MigNygro/tcc-conversor-flyback/02_Calculos/Especificações_TCC.xlsx

Sheet: Dados_Projeto
Dados Basicos do Projeto |  |  | Dados do Indutor Acoplado |  |  | LEGENDA
Parametro | Valor | Unidade | Modelo | T106-26 |  |  | Dado Manual do Usuário
V microcontrolador | 5 | V | Lm | 450000 | uH |  | Dado Calculado
V in(max) | 12 | V | Fio | 24 | AWG
V in rms | 12 | V | Voltas N1 p/ Fio | 69 | Voltas
V in(min) | 12 | V | Qntd Fios N1 | 1 | Fios
V out | 5 | V | Qntd Fios N2 | 12.32 | Fios
R out | 10 | Ω | Total Voltas | 1 | Voltas
L Trafo Requerido | 450 | uH | N2/N1 | 0.1785714286 | Constante
L Trafo Requerido | 0.00045 | H | Capacitor Comercial | 3.3e-05 | Faraday
N1/N2 | 4.5 | - | Capacitor Comercial | 33 | uF
N1/N2 | 5.6 | -
Escolha o Mosfet | IRF640
Frequência | 62.5 | kH | Valor Medido | 1.495 | mH
Frequência | 62500 | H | Voltas | 20
β(SAT) | 10 |  | Nano Henry | 1495000
I min gate Drive (IC) | 1 | mA | Al Medido | 3737.5 | nH/N^2
I min gate Drive (IC) | 0.001 | A
I máx Gate Mosfet 1% | 0.254 | A | Valor Medido | 0.013 | mH
I máx Gate Mosfet 1% | 254 | mA | Voltas | 10
Rb Opto | 18000 | Ω | Nano Henry | 13000
R1 Gate Drive | 4700 | Ω | Al Medido | 130 | nH/N^2
R2 Gate Drive | 470 | Ω
R3 Gate Drive / Rg Mosfet | 47 | Ω
Definições para o Flyback
∆ Vo | 1 | %
V diodo | 0.7 | V
Duty Cicle | 0.7 | num
B max | 0.25 | Tesla
Tipo da Condução | Contínuo
Tipo do Indutor | Toroidal
Tipo da Condução | Qual Fio
Fio AWG | 24 | AWG

Sheet: Estudo_Drive
 | 1.39 |  |  |  |  | aaaaaaaaaaaaaaaaaaaa | aaaaaa | aaaaa | Vcc Arduino | 5 |  | mA
 | 1.666666667 |  |  |  |  |  |  |  | Vcc | 12 | V
IB3 | 1666.666667 | mA | Ib Entrada | 2 | mA |  |  |  | Ig | 0.254 | A | 254
IB3 | 0.001 | A | Ib Entrada | 0.002 | A |  |  |  | R3 | 47.24409449 | Ω
β(SAT) | 10 | num | V microcontrolador | 5 | V |  |  |  | R3 cmc | 47 | Ω
IC3 | 16666.66667 | mA | R1 Rb | 2500 | Ohm
IC3 | 16.66666667 | A | Resistor cmc | #REF! | Ohm |  |  |  | Ec | 7.2e-08 | J
Vdd | 12 | V |  |  |  |  |  |  | Ec | 72 | nJ
R3 | 0.72 | Ω |  |  |  |  |  |  | T esquisito | 4.724409449e-08 | s
R3 cmc | #REF! | Ω |  |  |  |  |  |  | T esquisito | 47.24409449 | ns
Ciss | 1 | nF | R1 do Drive usando BC337 e ib = 2 mA |  |  | R2 do Drive usando BC337 e ib = 2 mA |  |  | t | 236.2204724 | ns
E | 7.2e-08 | J | Relação Ib/Ic | 10 |  | Relação Ib/Ic | 10
E | 72 | J | Ib Q1 | 2 | mA | Ib Q1 | 20 | mA | f | 62500 | hz
t | 7.2e-10 | s | Ic Q1 | 20 | mA | Ic Q1 | 200 | mA | T | 1.6e-05 | s
t | 0.72 | ns | Ic Q1 | 0.02 | A | Ic Q1 | 0.2 | A | T | 16 | us
t | 3.6e-09 | s | Vdd = vcc | 12 | V | Vdd = vcc | 12 | V
t | 3.6 | ns | Rc Q1/ Rb Q2 | 600 | Ohm | Rc Q1/ Rb Q2 | 60 | Ohm | P | 4.5 | mW
 |  |  | Rc Q1/ Rb Q2 cmc | #REF! | Ohm | Rc Q1/ Rb Q2 cmc | #REF! | Ohm
T | 1.6e-05 | s | Ic Q1 = Ib Q2 | #REF! | A | Ic Q1 = Ib Q2 | #REF! | A | IB3 = IR2 | 0.0254 | A | 25.4
T | 16000 | ns | Ic Q1 = Ib Q2 | #REF! | mA | Ic Q1 = Ib Q2 | #REF! | mA | R2 | 444.8818898 | Ω | Menor Melhor
Pmed | 0.0045 | W |  |  |  |  |  |  | R2 cmc | 470 | Ω
Pmed | 4.5 | mW
 |  |  | R1 do Drive usando Opto |  |  | R2 do Drive usando Opto |  |  | Ib2 = Ic2/10 | 0.00254 | A | 2.54
IB3 | 1666.666667 | mA | Relação Ib/Ic | 10 |  | Relação Ib/Ic | 10 |  | R1 | 4448.818898 | Ω
IB3 | 1.666666667 | A | Ib Q1 | 5 | mA | Ib Q1 | 0.5 | mA | R1 cmc | 4700 | Ω
R2 | 6.78 | Ω | Ic Q1 | 0.5 | mA | Ic Q1 | 5 | mA
R2 cmc | #REF! | Ω | Ic Q1 | 0.0005 | A | Ic Q1 | 0.005 | A | Ib2 = Ic2/10 | 0.000254 | A | 0.254
 |  |  | Vdd = vcc | 12 | V | Vdd = vcc | 12 | V | R1 | 16929.13386 | Ω
IC2 | 1666.666667 | mA | Rc Q1/ Rb Q2 | 24000 | Ohm | Rc Q1/ Rb Q2 | 2400 | Ohm | R1 cmc | 18000 | Ω
IC2 | 1.666666667 | A | Rc Q1/ Rb Q2 cmc | #REF! | Ohm | Rc Q1/ Rb Q2 cmc | #REF! | Ohm
IB2 | 166.6666667 | mA | Ic Q1 = Ib Q2 | #REF! | A | Ic Q1 = Ib Q2 | #REF! | A
IB2 | 0.1666666667 | A | Ic Q1 = Ib Q2 | #REF! | mA | Ic Q1 = Ib Q2 | #REF! | mA
R1 | 67.8 | Ω
R1 cmc | #REF! | Ω

Sheet: Estudo_Mosfet
MOSFET P75NF75 |  |  |  |  |  |  | MOSFET IRF540
Circ. Teste Datasheet | Parâmetro | Descrição | Condição | Valor Típico | Valor Máximo | Unidade | Circ. Teste Datasheet | Parâmetro | Descrição | Condição | Valor Típico | Valor Máximo | Unidade
 | tD(ON) | Turn-On Delay Time | VDD=37,5V, ID=45A, VGS=10V, RG=4,7Ω | 25 |  | ns |  | tD(ON) | Turn-On Delay Time | VDD=37,5V, ID=45A, VGS=10V, RG=4,7Ω | 8 |  | ns
 | tR | Turn-On Rise Time | VDD=37,5V, ID=45A, VGS=10V, RG=4,7Ω | 100 |  | ns |  | tR | Turn-On Rise Time | VDD=37,5V, ID=45A, VGS=10V, RG=4,7Ω | 39 |  | ns
 | tD(OFF) | Turn-Off Delay Time | VGS=10V, RG=4,7Ω | 66 |  | ns |  | tD(OFF) | Turn-Off Delay Time | VGS=10V, RG=4,7Ω | 26 |  | ns
 | tF | Turn-Off Fall Time | VGS=10V, RG=4,7Ω | 30 |  | ns |  | tF | Turn-Off Fall Time | VGS=10V, RG=4,7Ω | 24 |  | ns
 | Qg | Total Gate Charge | VDS=60V, VGS=10V, ID=80A | 117 | 160 | nC |  | Qg | Total Gate Charge | VDS=60V, VGS=10V, ID=80A | 65 |  | nC
 | Qgs | Gate-Source Charge | VDS=60V, VGS=10V, ID=80A | 27 |  | nC |  | Qgs | Gate-Source Charge | VDS=60V, VGS=10V, ID=80A | 10 |  | nC
 | Qgd | Gate-Drain Charge | VDS=60V, VGS=10V, ID=80A | 47 |  | nC |  | Qgd | Gate-Drain Charge | VDS=60V, VGS=10V, ID=80A | 29 |  | nC
 | Ciss | Imput Capacitance | VGS = 0 V, VDS = 25 V f = 1MHz | 3700 |  | pF |  | Ciss | Imput Capacitance | VGS = 0 V, VDS = 25 V f = 1MHz | 890 | 1187 | pF
Dados Calculados | Qg Medio | Total Gate Charge | VDS=60V, VGS=10V, ID=80A | 139 |  | nC | Dados Calculados | Qg Medio | Total Gate Charge | VDS=60V, VGS=10V, ID=80A | 65 |  | nC
 | Ig Max | Corrente no Gate Max | VDS=60V, VGS=10V, ID=80A | 1.39 |  | A |  | Ig Max | Corrente no Gate Max | VDS=60V, VGS=10V, ID=80A | 1.666666667 |  | A
 | p% Pulso | Porcentagem de Pulso |  | 0.8 |  | % |  | p% Pulso | Porcentagem de Pulso |  | 1.6 |  | %
 | F tr | Frequencia de Trabalho |  | 62.5 |  | kH |  | F tr | Frequencia de Trabalho |  | 62.5 |  | kH
 | F tr | Frequencia de Trabalho |  | 62500 |  | H |  | F tr | Frequencia de Trabalho |  | 62500 |  | H
 | T tr | Periodo de Trabalho |  | 1.6e-05 | 10 | s |  | T tr | Periodo de Trabalho |  | 1.6e-05 |  | s
 | T tr | Periodo de Trabalho |  | 16000 |  | ns |  | T tr | Periodo de Trabalho |  | 16000 |  | ns
 | T pulso | T Pulso para não Aquecer o Mosfet + que 1% do Tr |  | 1.28e-07 |  | s |  | T pulso | T Pulso para não Aquecer o Mosfet + que 1% do Tr |  | 2.56e-07 |  | s
 | T pulso | T Pulso para não Aquecer o Mosfet + que 1% do Tr |  | 128 |  | ns |  | T pulso | T Pulso para não Aquecer o Mosfet + que 1% do Tr |  | 256 |  | ns
 | Ig Pulso | Corrente de Gate para esse pulso de 1% de Tr |  | 1.086 | 1.39 | A |  | Ig Pulso | Corrente de Gate para esse pulso de 1% de Tr |  | 0.254 | 1.666666667 | A
 | Vcc drive | Tensão de entrada ou do drive que irá adionar o mosfet |  | 12 |  | V |  | Vcc drive | Tensão de entrada ou do drive que irá adionar o mosfet |  | 12 |  | V
 | Rg | R gate do Mosfet para acionar em 1,086 A |  | 11.05 |  | Ohm |  | Rg | R gate do Mosfet para acionar em 0,254 A |  | 47.24 |  | Ohm
 | Rg cmc | R gate do Mosfet Comercial |  | 47 |  | Ohm |  | Rg cmc | R gate do Mosfet Comercial |  | 47 |  | Ohm
 |  | perda de potencia no mosfet
Link youtube | MOSFET: Acionamento do gate, resistência do gate (https://www.youtube.com/watch?v=UnN3hBL277I) | MOSFET: Por que usar a resistência de gate? (https://www.youtube.com/watch?v=WTB71her32k)

Sheet: Calculo_FlyBack_Simples
 |  |  | AAAAAA |  | aaaaaaa | aaaaaa | aaaaaaaaa |  | aaaaaaa | AAAAAA
 |  |  |  | Dados Basicos do Projeto |  |  | Teste do Modo de Operação |  |  |  | Cálculo do Fio Mínimo Bobina
Tap Trafo | Trafo Antigo |  |  | Parametro | Valor | Unidade | Parametro | Valor | Unidade |  | Parametro | Valor | Unidade
1º | 0.446 | mH |  | V in(max) | 12 | V | N1/N2 | 4.5000 |  |  | Profundidade de Penetração | 0.02648 | cm
 | 446 | uH |  | V in rms | 12 | V | N1/N2 | 5.6000 | 0.1785714286 |  | Diametro do Fio | 0.05296 | cm
2º | 0.099 | mH |  | V in(min) | 12 | V | N2/N1 | 0.2222 |  |  | Área do Fio (Aw) | 0.0022 | cm²
 | 99 | uH |  | V out (1) | 5 | V | N2/N1 | 0.1786 | 5.6 |  | Fio Mínimo Escolhido
N1/N2 | 4.505050505 |  |  | R out (1) | 100 | Ω | D (Max Real) | 0.7000 |  |  | Área do Fio (AWG) Mínimo | 0.00205 | cm²
N2/N1 | 0.2219730942 |  |  | I out (1) | 0.05 | A | N1/N2 | 4.5000 | - |  | Fio AWG | 24 | AWG
 |  |  |  | P out (1) | 0.25 | W | I Lm | 0.030 | A |  | Resistência | 842.1 | uΩ/cm 22º C
 |  |  |  | Duty Cicle | 0.7 |  | Qual Duty Cicle | Original |  |  | Fio AWG Escolhido | 24 | AWG
 |  |  |  | L Trafo Requerido | 450 | uH | ∆ I Lm | 0.299 | A |  | Área do Fio (AWG) Mínimo | 0.00205 | cm²
 |  |  |  | L Trafo Requerido | 0.00045 | H | Lm | 0.00045 | H |  | Resistência | 842.1 | uΩ/cm 22º C
 |  |  |  | ∆ Vo | 2 | % | Lm | 450 | uH
 |  |  |  | Frequência | 62.5 | kH | I Lm mín | -0.1193333333 | A |  | Imax | 0.1793333333 | A
 |  |  |  | Frequência | 62500 | H |  |  |  |  | Imax 1% | 0.001793333333 | A
 |  |  |  | Tipo da Condução | Contínuo |  | I Lm máx | 0.1793333333 | A |  | Imax 1% | 1.79 | mA
 |  |  |  | Tipo do Transformador | Toroidal |  | Modo de Operação Segundo Hart |  |  |  | R snubber | 6691 | Ω |  | 3.2e-09
 |  |  |  | Calculos Periodo |  |  | Descontínuo |  |  |  | R snubber cmc | 6800 | Ω |  | 3.2 | nJ
 |  |  |  | Periodo T | 1.6e-05 | s | Definindo o Núcleo |  |  |  | R snubber cmc | 6.8 | kΩ
 |  |  |  | Ton | 1.12e-05 | s | Al do Núcleo | 93 | nH/Np² |  | Ei | 7.2361e-10 | J |  | 6.4
 |  |  |  |  | 100 |  | Lm | 450000 | nH |  | Ei | 0.72361 | nJ
 |  |  |  |  |  |  | Número de Voltas Primário | 69 | Voltas |  | V teste | 2 | V
 |  |  |  |  |  |  | Qntd Fios Primario | 1 | Fios |  | c snb | 3.61805e-10 | J
 |  |  |  |  |  |  | Número de Voltas Secundário | 15.33333333 | Voltas |  | c snb | 0.000361805 | uF
 |  |  |  |  |  |  | Qntd Fios Secundário | 1 | Fios |  | c snb cmc | 4.7e-10 | F
 |  |  |  |  |  |  | Qual Fio | 24 | AWG |  | c snb cmc | 470 | pF | 0.47
 |  |  |  |  |  |  | Número de Voltas Secundário | 12.32 | Voltas |  | C carga | 2.8e-05 | 0.012
 |  |  |  |  |  |  | Qntd Fios Secundário | 1 | Fios |  | C Carga cmc | 3.3e-05 | F
 |  |  |  |  |  |  | Qual Fio | 0 | AWG |  | C Carga cmc | 33 | uF |  | 3300 | 3300
 |  |  |  |  |  |  | Modo de Operação Segundo Hart
 |  |  |  |  |  |  | Contínuo
 |  |  |  |  |  |  | 0.00225792 | lm
 |  |  |  |  |  |  | 2257.92 | uLm
 |  |  |  |  |  |  | 11.2

Sheet: Planilha1
Item | Valor aproximado (R$)
Microcontrolador | XX,00
MOSFET de potência | XX,00
Núcleo toroidal | XX,00
Componentes passivos | XX,00
Custo total estimado | XX,00

Sheet: Estudo_OptoAcoplador
OPTOACOPLADOR 4N25
Circuito | Parametro | Valor | Unidade |  | Parametro | Valor | Unidade
Circ. Teste Datasheet Vin | IC | 1 | mA |  | Ton | 2 | us
 | IC | 0.001 | A |  |  | 2e-06 | s
 | Vcc | 10 | V |  | Toff | 2 | us
 | RL | 100 | Ohm |  |  | 2e-06 | s
 | CTR | 20 | % |  | T Total | 4 | us
 | IF | 5 | mA
 | I coletor | 0.0002 | A |  |  | 4e-06 | s
 | I coletor | 0.2 | mA |  | F máx 0,10 mA | 0.25 | MH
 | Queda T Vrl | 0.02 | V |  |  | 250 | kH
 | Vce Final | 9.98 | V |  |  | 250000 | H
 | V F Led Emissor Tip | 1.18 | V
 | V F Led Emissor Max | 1.5 | V
Circ. Micro Controlador | Vcc/Vin MicroContr | 5 | V
 | V F Led | 1.18 | V
 | I base Led | 5 | mA
 | I base Led | 0.005 | A
 | ResistenciaRg | 764 | Ohm
 | Resistencia Comerc. | 18000 | Ohm | Menor
 | I Base Led New | 0.0002122222222 | A
 | I Base Led New | 0.2122222222 | mA
 | Diferença I base | -95.76 | %

Sheet: Anal_Tubes
Numero | Diâmetro | Espiras | Área | Resistência | Peso | Comprim. | Corrente máxima (A) |  |  | Frequência | Corrente_Max | Frequencia | 5 % HZ | Teste_HZ | Qntd_Fios | Corrente_2 | Qntd_Fios_2
AWG | (mm) | por cm | (mm2) | (Ω/km) | (kg/km) | (m/kg) | 2,5A/mm2 | 3A/mm2 | 6A/mm2 | máx. (kHz) | A | Hz | Hz | - | Numero |  | Numero
1 | 7.3482 | 1.361 | 42.409 | 0.406 | 380 | 2.6317 | 106.022 | 127.226 | 254.453 | 0.323 | 0.1793333333 | 62.5 | 59.375 | Não |  | 0.05
2 | 6.5438 | 1.528 | 33.632 | 0.511 | 301.3 | 3.3185 | 84.08 | 100.896 | 201.792 | 0.407 | 0.1793333333 | 62.5 | 59.375 | Não |  | 0.05
3 | 5.8275 | 1.716 | 26.671 | 0.645 | 239 | 4.1845 | 66.679 | 80.014 | 160.029 | 0.513 | 0.1793333333 | 62.5 | 59.375 | Não |  | 0.05
4 | 5.1895 | 1.927 | 21.152 | 0.813 | 189.5 | 5.2765 | 52.879 | 63.455 | 126.91 | 0.647 | 0.1793333333 | 62.5 | 59.375 | Não |  | 0.05
5 | 4.6214 | 2.164 | 16.774 | 1.025 | 150.3 | 6.6535 | 41.935 | 50.322 | 100.645 | 0.816 | 0.1793333333 | 62.5 | 59.375 | Não |  | 0.05
6 | 4.1155 | 2.43 | 13.303 | 1.293 | 119.2 | 8.3899 | 33.256 | 39.908 | 79.815 | 1.029 | 0.1793333333 | 62.5 | 59.375 | Não |  | 0.05
7 | 3.665 | 2.729 | 10.549 | 1.63 | 94.52 | 10.579 | 26.374 | 31.648 | 63.297 | 1.297 | 0.1793333333 | 62.5 | 59.375 | Não |  | 0.05
8 | 3.2638 | 3.064 | 8.366 | 2.056 | 74.96 | 13.34 | 20.915 | 25.098 | 50.197 | 1.636 | 0.1793333333 | 62.5 | 59.375 | Não |  | 0.05
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
39 | 0.0897 | 111.48 | 0.00632 | 2721.651 | 0.05662 | 17660.2 | 0.0158 | 0.019 | 0.0379 | 2165.821 | 0.1793333333 | 62.5 | 59.375 | Sim |  | 0.05
40 | 0.07988 | 125.184 | 0.00501 | 3431.916 | 0.04491 | 22269 | 0.0125 | 0.015 | 0.0301 | 2731.032 | 0.1793333333 | 62.5 | 59.375 | Sim |  | 0.05
41 | 0.07114 | 140.573 | 0.00397 | 4327.537 | 0.03561 | 28080.5 | 0.00994 | 0.0119 | 0.0238 | 3443.745 | 0.1793333333 | 62.5 | 59.375 | Sim |  | 0.05
42 | 0.06335 | 157.853 | 0.00315 | 5456.888 | 0.02824 | 35408.6 | 0.00788 | 0.00946 | 0.0189 | 4342.454 | 0.1793333333 | 62.5 | 59.375 | Sim |  | 0.05
43 | 0.05642 | 177.258 | 0.0025 | 6880.963 | 0.0224 | 44649.1 | 0.00625 | 0.0075 | 0.015 | 5475.697 | 0.1793333333 | 62.5 | 59.375 | Sim |  | 0.05
44 | 0.05024 | 199.048 | 0.00198 | 8676.677 | 0.01776 | 56301.1 | 0.00496 | 0.00595 | 0.0119 | 6904.681 | 0.1793333333 | 62.5 | 59.375 | Sim |  | 0.05

Sheet: Formulas_Daniel_HART
Exercicio 1 |  |  |  | Exercicio 2 |  |  |  | Exercicio 3
V in | 24 | V |  | V in | 0.3 | V |  | V in | 24 | V
P in | 5 | W |  | P in | 3.6 | W |  | P in | 1.25 | W
I in | 0.2083333333 | A |  | I in | 12 | A |  | I in | 0.05208333333 | A
V out | 5 | V |  | V out | 36 | V | Vin/vout | V out | 5 | V
P out | 5 | W |  | P out | 3.6 | W |  | P out | 1.25 | W
I out | 1 | A |  | I out | 0.1 | A |  | I out | 0.25 | A
R out | 5 | Ohm |  | R out | 360 | Ohm |  | R out | 20 | Ohm
Freq | 40 | kHz |  | Freq | 25 | kHz |  | Freq | 40 | kHz
Freq | 40000 | Hz |  | Freq | 25000 | Hz |  | Freq | 40000 | Hz
D manual | 0.5 |  |  | D manual | 0.4 |  |  | D manual | 0.5
D calc | 0.385 |  |  | D calc | 0.4 |  |  | D calc | 0.385
D calc depend | V in && V out && N1/N2 |  |  | D calc depend | V in && V out && N1/N2 |  |  | D calc depend | V in && V out && N1/N2
N2/N1 manual | 3 |  |  | N2/N1 manual | 3 |  |  | N2/N1 manual | 3
N1/N2 | 0.3333333333 |  |  | N1/N2 | 0.005555555556 |  |  | N1/N2 | 0.3333333333
N2/N1 calc |  |  |  | N2/N1 calc | 180 |  |  | N2/N1 calc
Lm Manual | 200 | uH |  | Lm Manual | 500 | uH |  | Lm Manual | 500 | uH
Lm Manual | 0.0002 | H |  | Lm Manual | 0.0005 | H |  | Lm Manual | 0.0005 | H
 |  |  |  | Lm Calc | 4e-07 | H | 0.4 | Lm Calc | 0.0005
C manual | 200 | uF |  | C manual | 200 | uF |  | C manual | 200 | uF
C calc |  | F |  | C calc | 2.777777778e-06 | F |  | C calc
I Lm | 0.541 | A |  | I Lm | 30 | A |  | I Lm | 0.135 | A
I Lm depend | V out && V in && D manual && R out |  |  | I Lm depend | V out && V in && D manual && R out |  |  | I Lm depend | V out && V in && D manual && R out
∆ I Lm | 1.155 | A | 213.4935305% | ∆ I Lm | 12 | A | 40% | ∆ I Lm | 0.462 | A
 | V in && D calc && Lm Manual && Freq |  |  |  | V in && D calc && Lm Manual && Freq |  |  |  | V in && D calc && Lm Manual && Freq
I Lm Max | 1.1185 | A |  | I Lm Max | 36 | A |  | I Lm Max | 0.366 | A
I Lm Min | -0.0365 | A |  | I Lm Min | 24 | A |  | I Lm Min | -0.096 | A
∆ Vout Manual Riple | 2 | % |  | ∆ Vout Manual Riple | 2 | % |  | ∆ Vout Manual Riple | 1 | %
∆ Vout / Vo | 0.0096 | % |  | ∆ Vout / Vo | 0.016 | %/100 |  | ∆ Vout / Vo | 0.0024 | %
∆ Vout / Vo | 0.96 | %/100 |  | ∆ Vout / Vo | 1.6 | % |  | ∆ Vout / Vo | 0.24 | %/100
Teste | Tá Dentro |  |  | Teste | Tá Dentro |  |  | Teste | Tá Dentro
 |  |  |  | V riple | 0.72 | V
 |  |  |  | ∆ ic | 0.2
 |  |  |  | rc | 3.6
 |  |  |  | C | 2.777777778e-06 | F | 2.777777778 | uF
 |  |  |  | Is | 12 | A

Sheet: Capacitores_Comerciais
Capacitores Comerciais (com vírgula) | Fator para Farads | Em Faraday | Capacitor_TCC | C_TCC | Capacitor_Snubber_OFF | C_Sb_off
1 | 1e-12 | 1e-12 | 2.8e-05 | Não | 3.61805e-10 | Não
1.5 | 1e-12 | 1.5e-12 | 2.8e-05 | Não | 3.61805e-10 | Não
2.2 | 1e-12 | 2.2e-12 | 2.8e-05 | Não | 3.61805e-10 | Não
3.3 | 1e-12 | 3.3e-12 | 2.8e-05 | Não | 3.61805e-10 | Não
4.7 | 1e-12 | 4.7e-12 | 2.8e-05 | Não | 3.61805e-10 | Não
5.6 | 1e-12 | 5.6e-12 | 2.8e-05 | Não | 3.61805e-10 | Não
6.8 | 1e-12 | 6.8e-12 | 2.8e-05 | Não | 3.61805e-10 | Não
10 | 1e-12 | 1e-11 | 2.8e-05 | Não | 3.61805e-10 | Não
15 | 1e-12 | 1.5e-11 | 2.8e-05 | Não | 3.61805e-10 | Não
22 | 1e-12 | 2.2e-11 | 2.8e-05 | Não | 3.61805e-10 | Não
33 | 1e-12 | 3.3e-11 | 2.8e-05 | Não | 3.61805e-10 | Não
47 | 1e-12 | 4.7e-11 | 2.8e-05 | Não | 3.61805e-10 | Não
56 | 1e-12 | 5.6e-11 | 2.8e-05 | Não | 3.61805e-10 | Não
68 | 1e-12 | 6.8e-11 | 2.8e-05 | Não | 3.61805e-10 | Não
100 | 1e-12 | 1e-10 | 2.8e-05 | Não | 3.61805e-10 | Não
150 | 1e-12 | 1.5e-10 | 2.8e-05 | Não | 3.61805e-10 | Não
220 | 1e-12 | 2.2e-10 | 2.8e-05 | Não | 3.61805e-10 | Não
330 | 1e-12 | 3.3e-10 | 2.8e-05 | Não | 3.61805e-10 | Não
470 | 1e-12 | 4.7e-10 | 2.8e-05 | Não | 3.61805e-10 | Sim
560 | 1e-12 | 5.6e-10 | 2.8e-05 | Não | 3.61805e-10 | Sim
680 | 1e-12 | 6.8e-10 | 2.8e-05 | Não | 3.61805e-10 | Sim
1000 | 1e-12 | 1e-09 | 2.8e-05 | Não | 3.61805e-10 | Sim
1500 | 1e-12 | 1.5e-09 | 2.8e-05 | Não | 3.61805e-10 | Sim
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
22000 | 1e-06 | 0.022 | 2.8e-05 | Sim | 3.61805e-10 | Sim
47000 | 1e-06 | 0.047 | 2.8e-05 | Sim | 3.61805e-10 | Sim
100000 | 1e-06 | 0.1 | 2.8e-05 | Sim | 3.61805e-10 | Sim
470000 | 1e-06 | 0.47 | 2.8e-05 | Sim | 3.61805e-10 | Sim
1000000 | 1e-06 | 1 | 2.8e-05 | Sim | 3.61805e-10 | Sim

Sheet: Resistores_Comerciais
Resistencia | R3_Novo | % R3_Novo | R3_Novo_cmc | R2_Novo | % R2_Novo | R2_Novo_cmc | R1_Novo | % R1_Novo | R1_Novo_cmc | Rg_Novo | % Rg_Novo | Rg_Novo_cmc | R_Snubber | % R_Snubber | R_Snubber_cmc
1 | 47.24409449 | 2.12% | Não | 444.8818898 | 0.22% | Não | 4448.818898 | 0.02% | Não | 16929.13386 | 0.01% | Não | 6691 | 0.01% | Não
1.2 | 47.24409449 | 2.54% | Não | 444.8818898 | 0.27% | Não | 4448.818898 | 0.03% | Não | 16929.13386 | 0.01% | Não | 6691 | 0.02% | Não
1.5 | 47.24409449 | 3.17% | Não | 444.8818898 | 0.34% | Não | 4448.818898 | 0.03% | Não | 16929.13386 | 0.01% | Não | 6691 | 0.02% | Não
1.8 | 47.24409449 | 3.81% | Não | 444.8818898 | 0.40% | Não | 4448.818898 | 0.04% | Não | 16929.13386 | 0.01% | Não | 6691 | 0.03% | Não
2.2 | 47.24409449 | 4.66% | Não | 444.8818898 | 0.49% | Não | 4448.818898 | 0.05% | Não | 16929.13386 | 0.01% | Não | 6691 | 0.03% | Não
2.7 | 47.24409449 | 5.71% | Não | 444.8818898 | 0.61% | Não | 4448.818898 | 0.06% | Não | 16929.13386 | 0.02% | Não | 6691 | 0.04% | Não
3.3 | 47.24409449 | 6.98% | Não | 444.8818898 | 0.74% | Não | 4448.818898 | 0.07% | Não | 16929.13386 | 0.02% | Não | 6691 | 0.05% | Não
3.9 | 47.24409449 | 8.25% | Não | 444.8818898 | 0.88% | Não | 4448.818898 | 0.09% | Não | 16929.13386 | 0.02% | Não | 6691 | 0.06% | Não
4.7 | 47.24409449 | 9.95% | Não | 444.8818898 | 1.06% | Não | 4448.818898 | 0.11% | Não | 16929.13386 | 0.03% | Não | 6691 | 0.07% | Não
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
82000 | 47.24409449 | 173566.67% | Sim | 444.8818898 | 18431.86% | Sim | 4448.818898 | 1843.19% | Sim | 16929.13386 | 484.37% | Sim | 6691 | 1225.53% | Sim
100000 | 47.24409449 | 211666.67% | Sim | 444.8818898 | 22477.88% | Sim | 4448.818898 | 2247.79% | Sim | 16929.13386 | 590.70% | Sim | 6691 | 1494.54% | Sim
120000 | 47.24409449 | 254000.00% | Sim | 444.8818898 | 26973.45% | Sim | 4448.818898 | 2697.35% | Sim | 16929.13386 | 708.84% | Sim | 6691 | 1793.45% | Sim
