MigNygro/tcc-conversor-flyback/04_Hardware/SCH_Esquema com BJT_2026-03-24.pdf

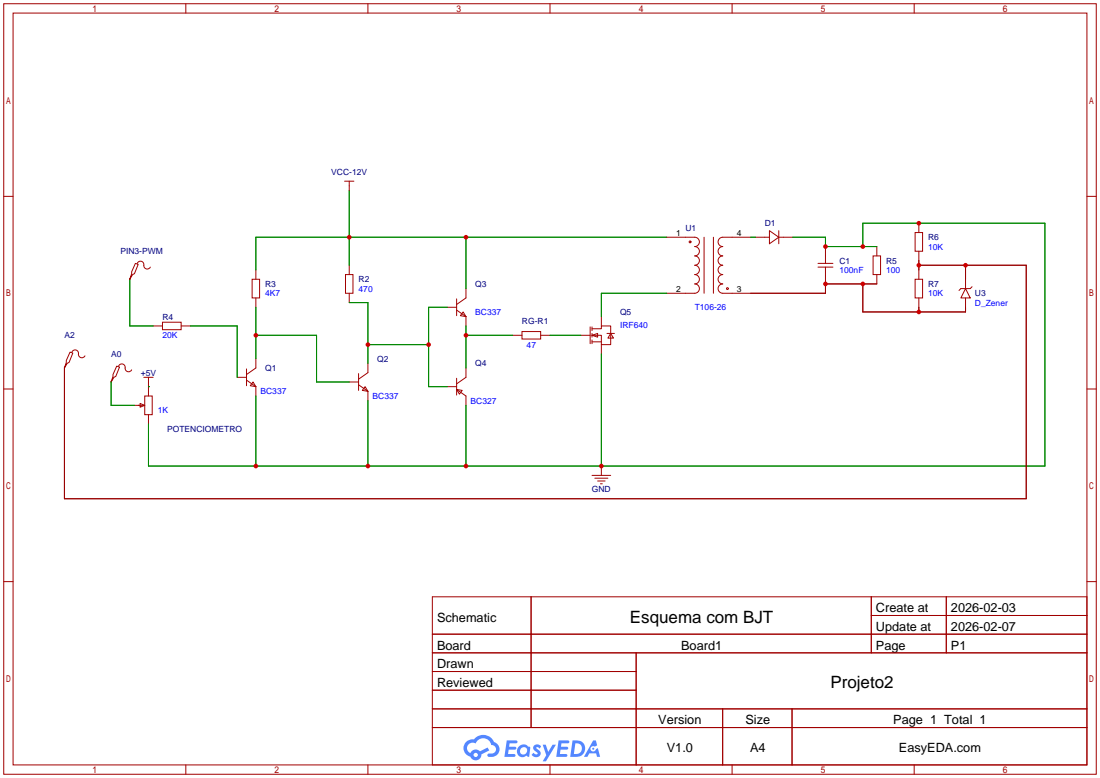
[picture p4: page 1]

Schematic | Esquema com BJT | Create at | 2026-02-03

Update at | 2026-02-07

Board | Board1 | Page | P1
Drawn | | Projeto2
Reviewed

Version | Size | Page 1 Total 1
V1.0 | A4 | EasyEDA.com
