MigNygro/tcc-conversor-flyback/(list of files, drawings)

Other design files:
04_Hardware/Projeto2.eprj
